bathwaterpizza/capivara_sensor/(commit log)

2023-11-07 Encapsulated some print strings into a flash macro
2023-11-07 Progress (need to fix onEvent)
    [capivara_sensor.ino]
2023-11-08 Integrated buzzer alert on read
    [capivara_sensor.ino]
2023-11-08 Progress: just fixed the core 1 crash
    [capivara_sensor.ino]
2023-11-09 Added multiple parameters and encapsulation for the buzzer task by calling play_tone
    [capivara_sensor.ino]
2023-11-10 Re-added vTaskDeletes because we were getting errors. Added parameters and encapsulation for blinking the read LED.
    [capivara_sensor.ino]
2023-11-16 Added DEVICE_ID to config, which will be sent in the POST JSON
2023-11-16 device_id is now sent as int instead of string
2023-11-16 Changed DEVICE_ID to CLASSROOM_ID
2023-11-29 Added screens for http success and error after reading a tag
    [capivara_sensor.ino]
2023-12-19 Fixing tiny merge conflict
    [capivara_sensor.ino, secrets.hpp]
2023-12-21 Fixed play_tone_blocking still using task delay
    [capivara_sensor.ino]
2024-01-27 Commented out LED functionality
2024-01-27 Fixed header name for linux compatibility (case sensitive)
    [events.cpp]
2024-03-09 Changed UI text from classroom to class, which better represents the current usage of classroom_id
2024-04-01 Made radio buttons required
2024-04-01 Fixed unchanged old variable in setcfg route handler
    [events.cpp]
